quarterturn/Sunburn-Monitor/sunburn-monitor-v2.brd

## EAGLE design sunburn-monitor-v2.brd (2015-03-04)

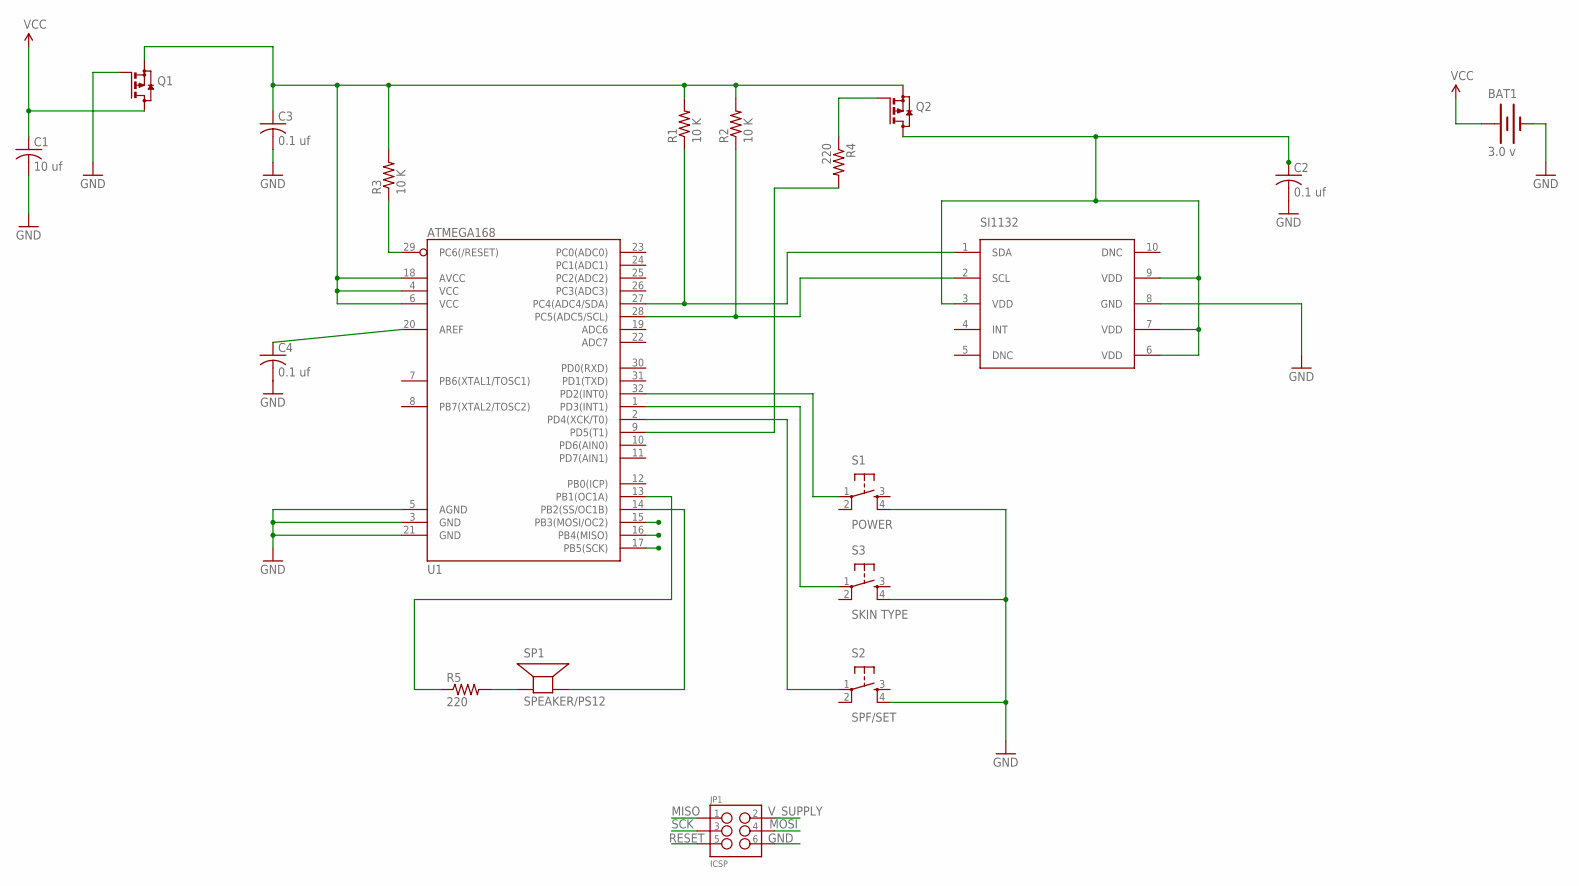
[picture p1: schematic sunburn-monitor-v2.sch]

Parts:
BAT1: 3.0 v; BATTCON_20MM
C1: 10 uf; C2012
C2, C3, C4: 0.1 uf; C2012
JP1: ICSP; 2X3-NS
Q1, Q2: SI2333DDS; SOT23
R1, R2, R3: 10 K; R2012
R4, R5: 220; R2012
S1: POWER; TACTILE_SWITCH_SMD
S2: SPF/SET; TACTILE_SWITCH_SMD
S3: SKIN TYPE; TACTILE_SWITCH_SMD
SP1: SPEAKER/PS12; PS12
U1: ATMEGA168; TQFP32-08
U2: SI1132; QFN-10

Connections:
GND: BAT1.2 (-), C1.2, C2.2, C3.2, C4.2, JP1.6, Q1.1 (G), S1.4, S2.4, S3.4, U1.3 (GND), U1.5 (AGND), U1.21 (GND), U2.8 (GND)
MISO: JP1.1, U1.16 (PB4(MISO))
MOSI: JP1.4, U1.15 (PB3(MOSI/OC2))
unnamed: R1.1, U1.27 (PC4(ADC4/SDA)), U2.1 (SDA)
unnamed: C4.1, U1.20 (AREF)
unnamed: R2.1, U1.28 (PC5(ADC5/SCL)), U2.2 (SCL)
unnamed: C2.1, Q2.3 (D), U2.3 (VDD), U2.6 (VDD), U2.7 (VDD), U2.9 (VDD)
unnamed: Q2.1 (G), R4.1
unnamed: S1.1, U1.32 (PD2(INT0))
unnamed: S3.1, U1.1 (PD3(INT1))
unnamed: S2.1, U1.2 (PD4(XCK/T0))
unnamed: R4.2, U1.9 (PD5(T1))
unnamed: R5.1, U1.13 (PB1(OC1A))
unnamed: R5.2, SP1.P$1 (+)
unnamed: SP1.P$2 (-), U1.14 (PB2(SS/OC1B))
RESET: JP1.5, R3.1, U1.29 (PC6(/RESET))
SCK: JP1.3, U1.17 (PB5(SCK))
VCC: BAT1.1 (+), C1.1, Q1.3 (D)
V_SUPPLY: C3.1, JP1.2, Q1.2 (S), Q2.2 (S), R1.2, R2.2, R3.2, U1.4 (VCC), U1.6 (VCC), U1.18 (AVCC)

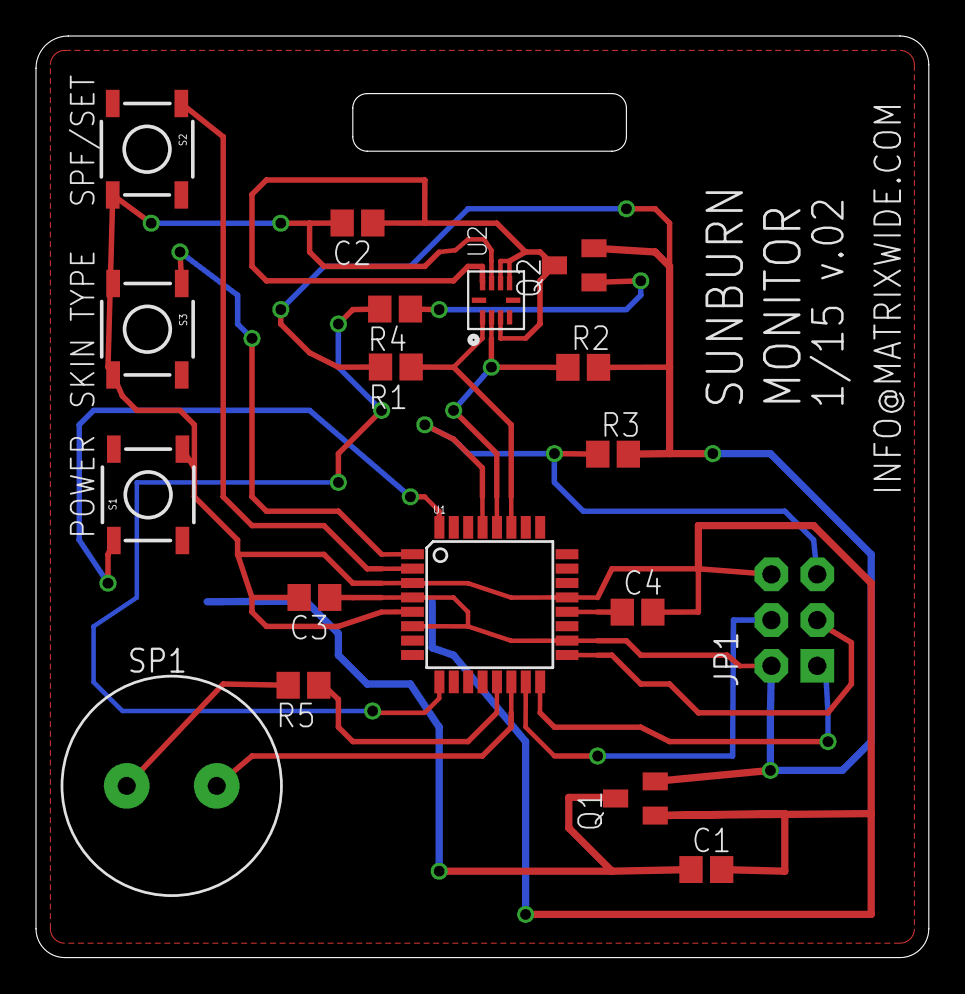
[picture p2: board sunburn-monitor-v2.brd from above]

Board: 2 copper layers, 49.6 x 51.2 mm, 19 parts (1 on the bottom side), 19 nets.
