quarterturn/Sunburn-Monitor/(commit log)

2015-03-04 Added Eagle files for v 0.2 board
    [sunburn-monitor-v2.brd, sunburn-monitor-v2.sch]
2015-04-05 updated requirement for 8 mHz MCU speed; added docs on fuses
